mcg56/remote-high-side-switch/README.md

# remote-high-side-switch
Connect to WiFI and enter IP address 192.168.4.1
