mcg56/remote-high-side-switch/Electrical/remote_pcb/remote_pcb.kicad_pcb

## KiCad design Electrical/remote_pcb/remote_pcb.kicad_pcb (2023-05-22)

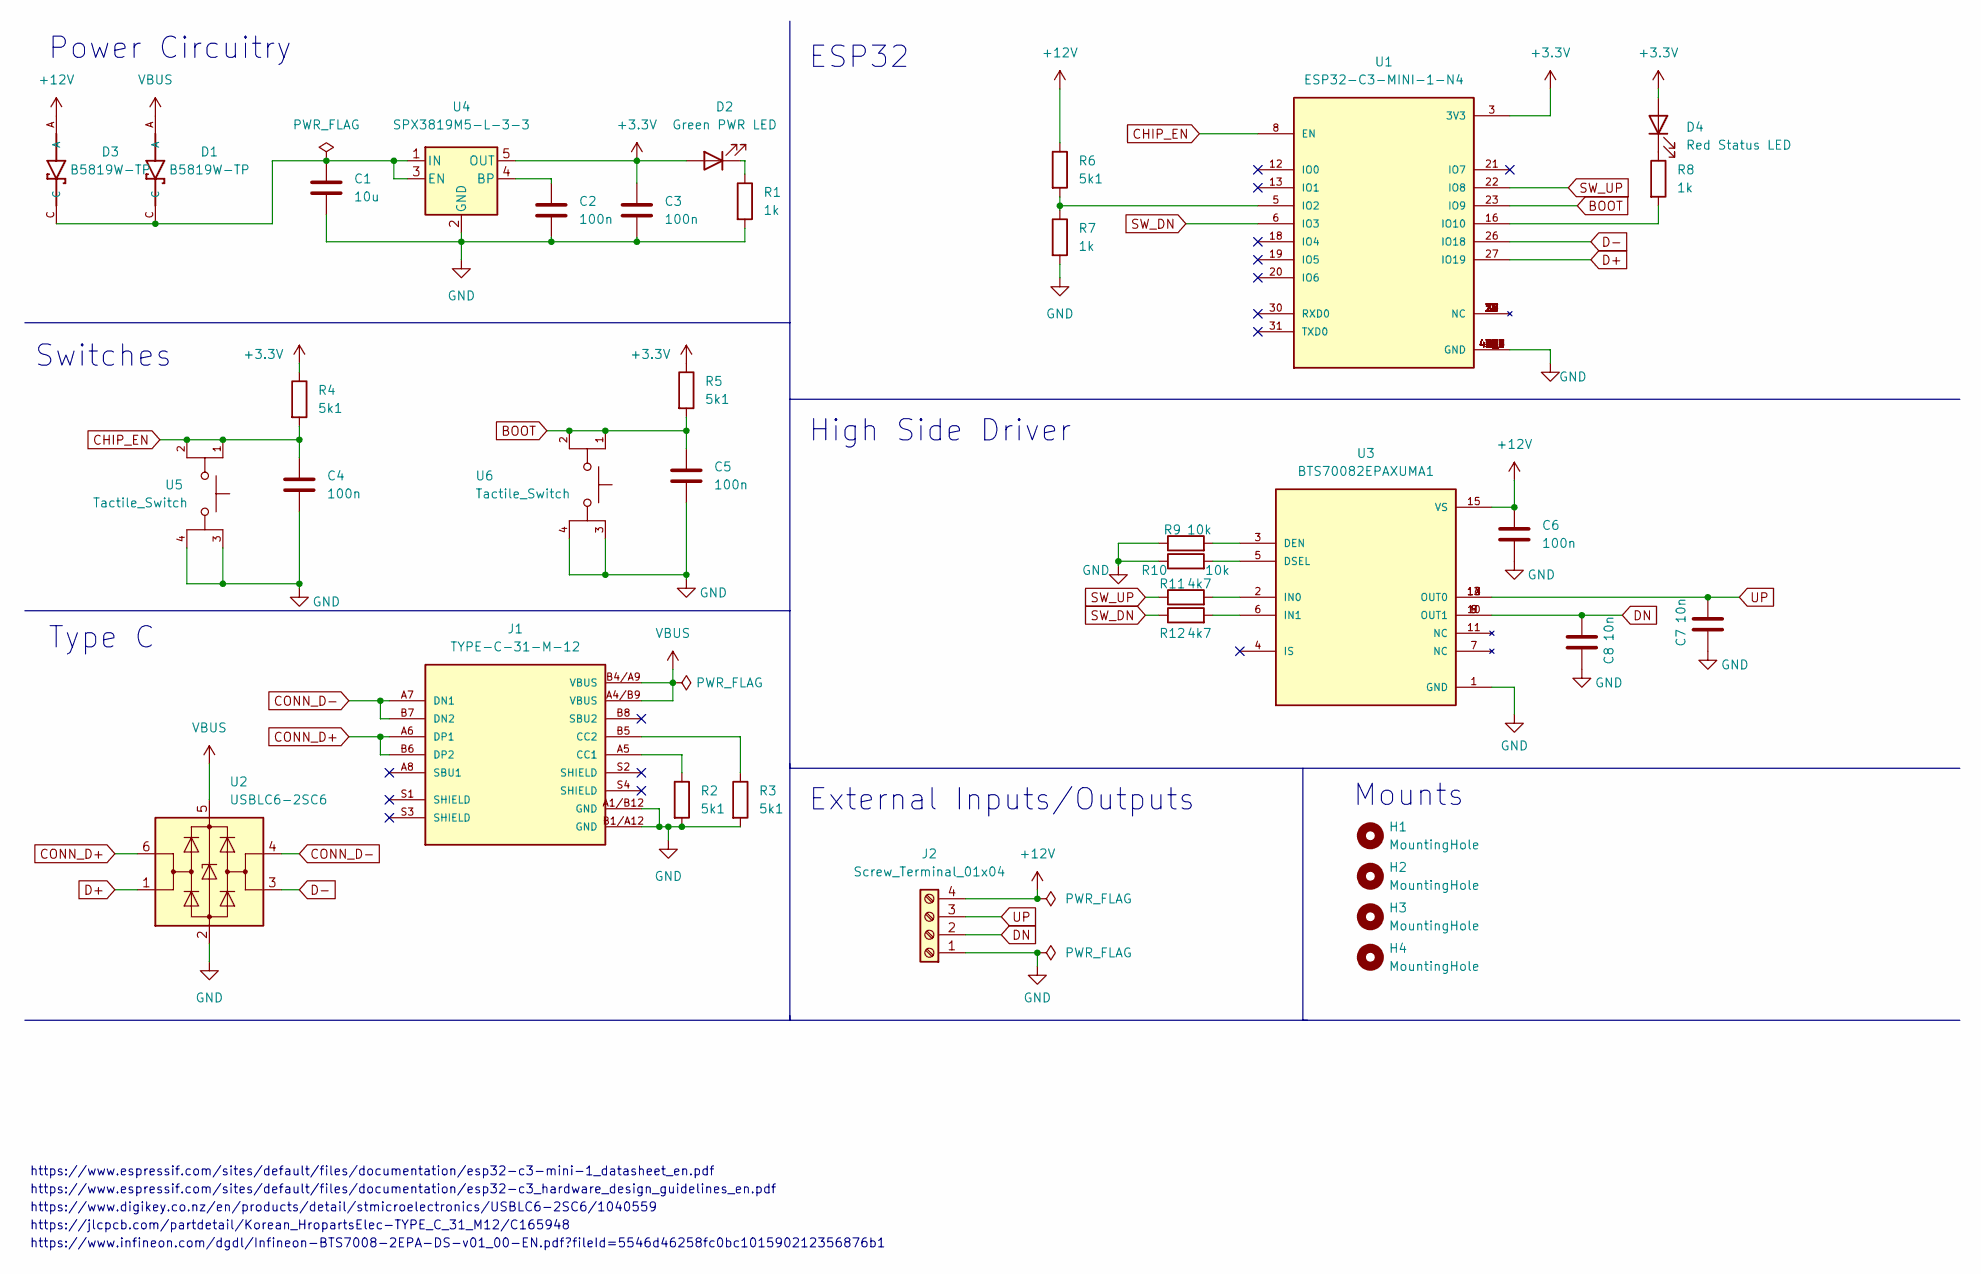
[picture p1: schematic remote_pcb.kicad_sch]

Parts:
C1: 10u; C_0603_1608Metric
C2, C3, C4, C5, C6: 100n; C_0603_1608Metric
C7, C8: 10n; C_0603_1608Metric
D1, D3: B5819W-TP; SOD3716X135N
D2: Green PWR LED; LED_0603_1608Metric
D4: Red Status LED; LED_0603_1608Metric
H1, H2, H3, H4: MountingHole; MountingHole_3.2mm_M3
J1: TYPE-C-31-M-12; PARTREV 2020.12.08
J2: Screw_Terminal_01x04; TerminalBlock_Phoenix_PT-1,5-4-3.5-H_1x04_P3.50mm_Horizontal
R1, R7, R8: 1k; R_0603_1608Metric
R2, R3, R4, R5, R6: 5k1; R_0603_1608Metric
R9, R10: 10k; R_0603_1608Metric
R11, R12: 4k7; R_0603_1608Metric
U1: ESP32-C3-MINI-1-N4; XCVR_ESP32-C3-MINI-1-N4; PARTREV v1.0
U2: USBLC6-2SC6; SOT-23-6
U3: BTS70082EPAXUMA1; SOP65P600X115-15N; PARTREV 1.14
U4: SPX3819M5-L-3-3; SOT-23-5
U5, U6: Tactile_Switch; Tactile Switch

Connections:
+3.3V: C3.1, D2.2 (A), D4.2 (A), R4.1, R5.1, U1.3 (3V3), U4.5 (OUT)
+12V: C6.1, D3.A, J2.4, R6.1, U3.15 (VS)
BOOT: C5.1, R5.2, U1.23 (IO9), U6.1, U6.2
CHIP_EN: C4.1, R4.2, U1.8 (EN), U5.1, U5.2
CONN_D+: J1.A6 (DP1), J1.B6 (DP2), U2.6 (I/O1)
CONN_D-: J1.A7 (DN1), J1.B7 (DN2), U2.4 (I/O2)
D+: U1.27 (IO19), U2.1 (I/O1)
D-: U1.26 (IO18), U2.3 (I/O2)
DN: C8.1, J2.2, U3.8 (OUT1), U3.9 (OUT1), U3.10 (OUT1)
GND: C1.2, C2.2, C3.2, C4.2, C5.2, C6.2, C7.1, C8.2, J1.A1/B12 (GND), J1.B1/A12 (GND), J2.1, R1.2, R2.2, R3.2, R7.2, R9.1, R10.1, U1.1 (GND), U1.2 (GND), U1.11 (GND), U1.14 (GND), U1.36 (GND), U1.37 (GND), U1.38 (GND), U1.39 (GND), U1.40 (GND), U1.41 (GND), U1.42 (GND), U1.43 (GND), U1.44 (GND), U1.45 (GND), U1.46 (GND), U1.47 (GND), U1.48 (GND), U1.49_1 (GND), U1.49_2 (GND), U1.49_3 (GND), U1.49_4 (GND), U1.49_5 (GND), U1.49_6 (GND), U1.49_7 (GND), U1.49_8 (GND), U1.49_9 (GND), U1.50 (GND), U1.51 (GND), U1.52 (GND), U1.53 (GND), U2.2 (GND), U3.1 (GND), U4.2 (GND), U5.3, U5.4, U6.3, U6.4
unnamed: C1.1, D1.C, D3.C, U4.1 (IN), U4.3 (EN)
unnamed: C2.1, U4.4 (BP)
unnamed: D2.1 (K), R1.1
unnamed: D4.1 (K), R8.1
unnamed: J1.A5 (CC1), R2.1
unnamed: J1.B5 (CC2), R3.1
unnamed: R6.2, R7.1, U1.5 (IO2)
unnamed: R8.2, U1.16 (IO10)
unnamed: R9.2, U3.3 (DEN)
unnamed: R10.2, U3.5 (DSEL)
unnamed: R11.2, U3.2 (IN0)
unnamed: R12.2, U3.6 (IN1)
SW_DN: R12.1, U1.6 (IO3)
SW_UP: R11.1, U1.22 (IO8)
UP: C7.2, J2.3, U3.12 (OUT0), U3.13 (OUT0), U3.14 (OUT0)
VBUS: D1.A, J1.A4/B9 (VBUS), J1.B4/A9 (VBUS), U2.5 (VBUS)

Notes on the sheet:
Switches
https://www.espressif.com/sites/default/files/documentation/esp32-c3_hardware_design_guidelines_en.pdf
External Inputs/Outputs
https://jlcpcb.com/partdetail/Korean_HropartsElec-TYPE_C_31_M12/C165948
High Side Driver
ESP32
https://www.espressif.com/sites/default/files/documentation/esp32-c3-mini-1_datasheet_en.pdf
Mounts
Type C
https://www.infineon.com/dgdl/Infineon-BTS7008-2EPA-DS-v01_00-EN.pdf?fileId=5546d46258fc0bc101590212356876b1
https://www.digikey.co.nz/en/products/detail/stmicroelectronics/USBLC6-2SC6/1040559
Power Circuitry

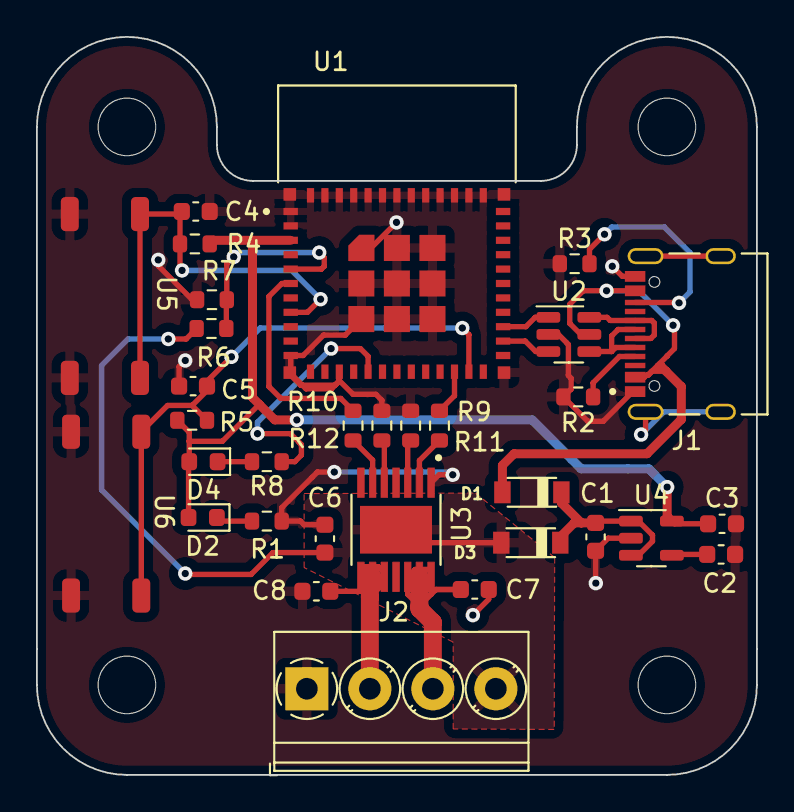
[picture p2: board remote_pcb.kicad_pcb from above]

Board: 2 copper layers, 40.0 x 41.0 mm, 36 parts (0 on the bottom side), 26 nets.
